ostertag/UACS/README.md

# UACS
University Access Controll System
