ostertag/UACS/stm32_interface/README.md

Here are schematics of connecting STM32F103C8T6 to our custom PCB
