ostertag/UACS/audio_amplifier/README.md

Here are schematics for UACS audio interface
