ostertag/UACS/leds/README.md

Here are schematics and short description for UACS LEDs
