ostertag/UACS/usb/README.md

Here are schematics and short description for UACS USB interface
