ostertag/UACS/reader/README.md

Here are all schematics, board designs and firmware source codes.
