ostertag/UACS/reader/hardware/README.md

Here is whole project from KICAD ver 9  
For production on JLCPCB site is advised to used plugin Fabrication toolkit for creating boom and plt files  
For detailed descriptions on of components, refer to [branch hardware_kozuch](https://github.com/ostertag/UACS/tree/hardwear_kozuch)
