ostertag/UACS/whole_reader/reader/cc-by-nc-sa-eu.png

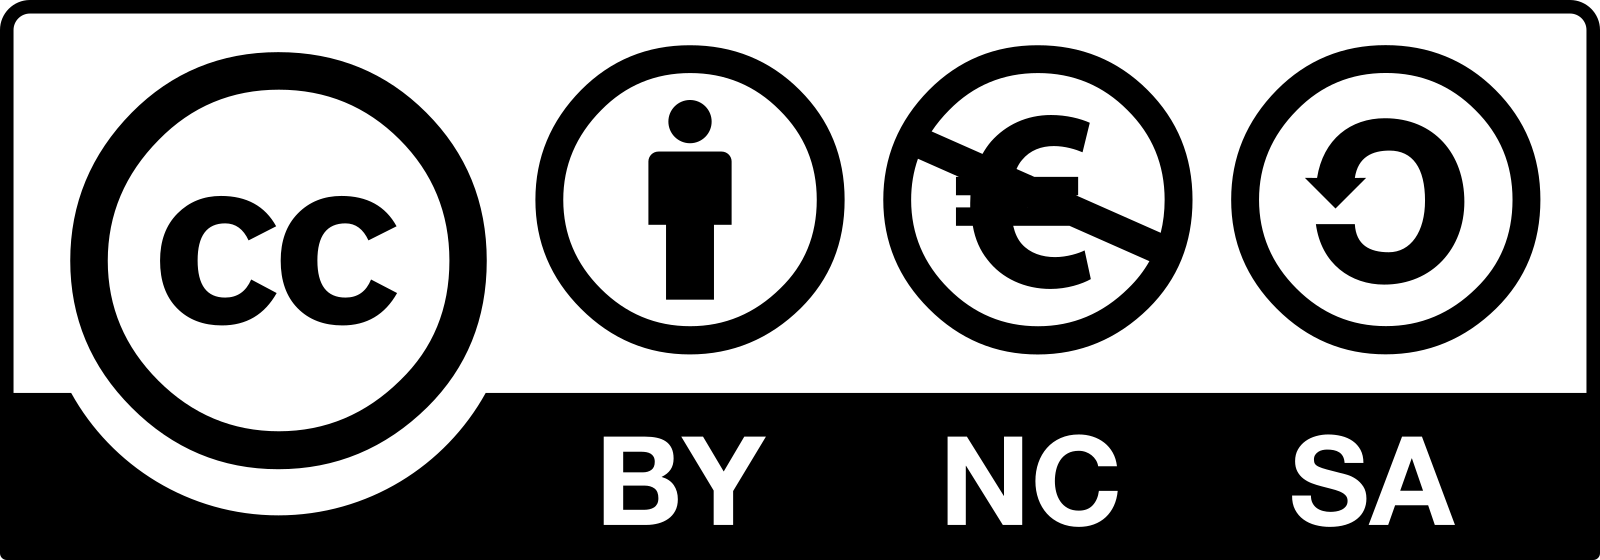
whole_reader/reader/cc-by-nc-sa-eu.png
