ostertag/UACS/whole_reader/reader/reader.png

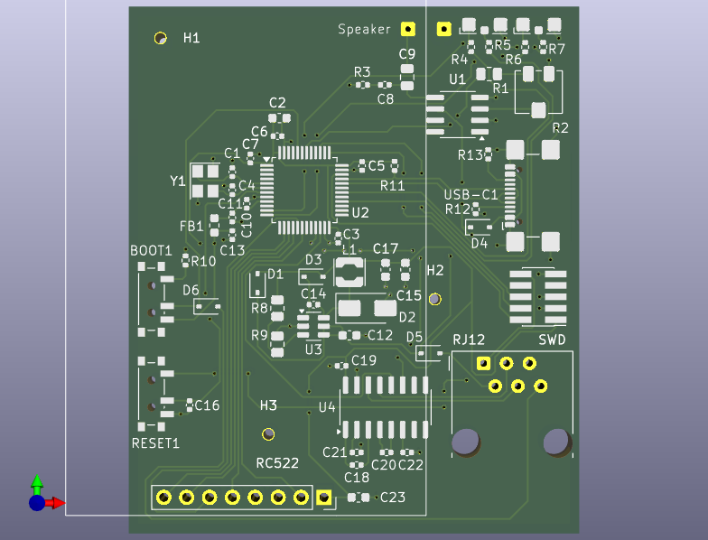
whole_reader/reader/reader.png
