ostertag/UACS/whole_reader/reader/reader_b.png

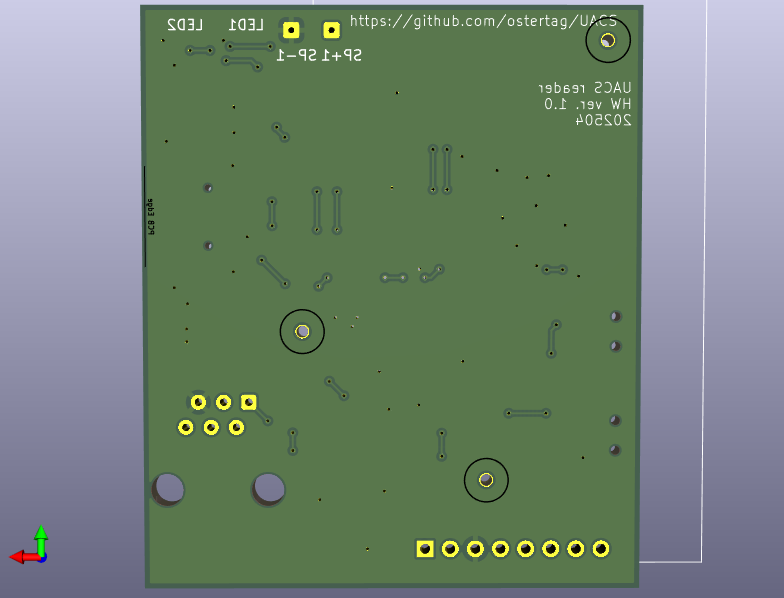
whole_reader/reader/reader_b.png
