ostertag/UACS/V2/kicad/LQFP48_STM.step

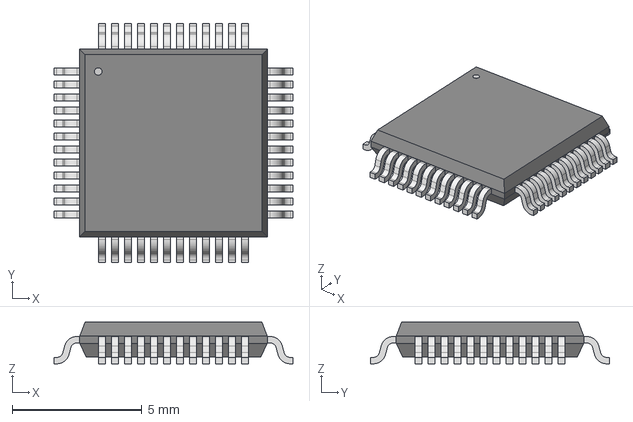
[picture p19: CAD file, 2026-04-23]
V2/kicad/LQFP48_STM.step
9.19 x 9.19 x 1.60 mm
