ostertag/UACS/whole_reader/reader/3D_models/APFA3010.STEP

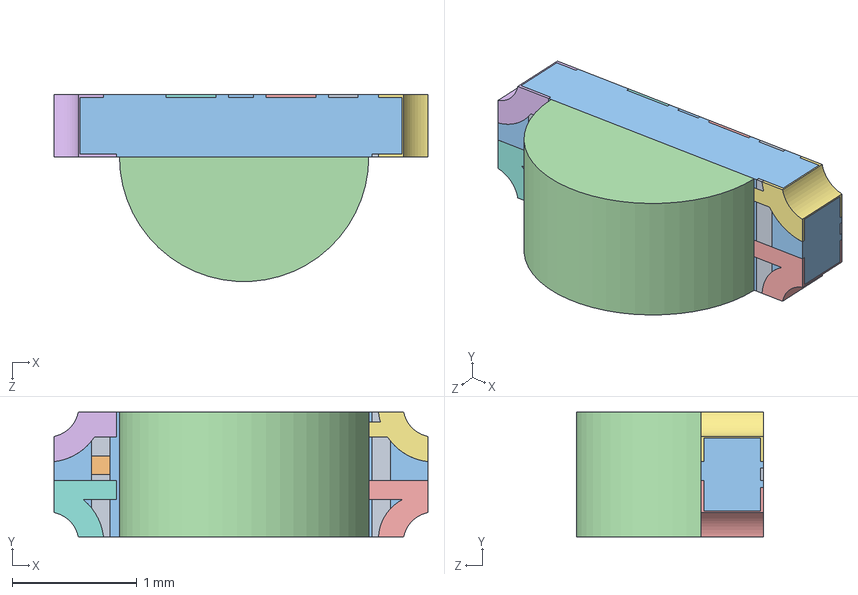
[picture p20: CAD file, 2026-03-26]
whole_reader/reader/3D_models/APFA3010.STEP
3.00 x 1.00 x 1.50 mm
