ostertag/UACS/whole_reader/reader/3D_models/GCT_USB4110GFA/USB4110-GF-A.stp

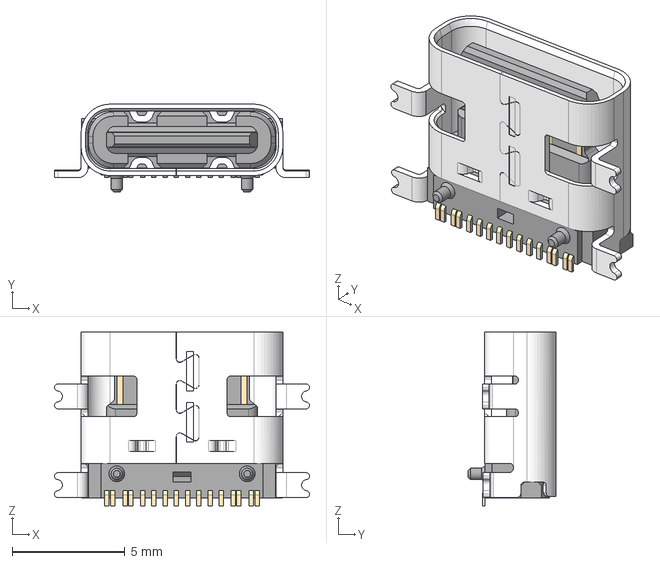
[picture p21: CAD file, 2026-03-26]
whole_reader/reader/3D_models/GCT_USB4110GFA/USB4110-GF-A.stp
11.3 x 3.89 x 7.70 mm
