ostertag/UACS/whole_reader/reader/3D_models/162191322-3-0530470210/0530470210.stp

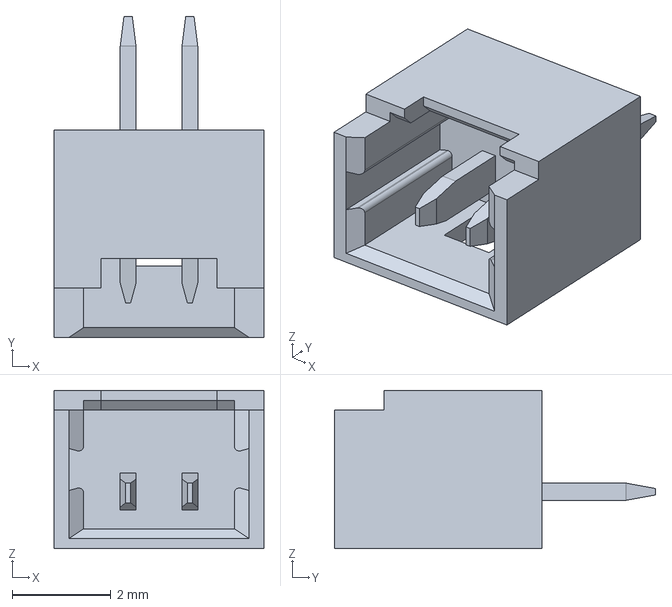
[picture p22: CAD file, 2026-03-26]
whole_reader/reader/3D_models/162191322-3-0530470210/0530470210.stp
4.25 x 6.50 x 3.20 mm
