ostertag/UACS/whole_reader/reader/3D_models/54601_906WPLF/54601-906WPLF.step

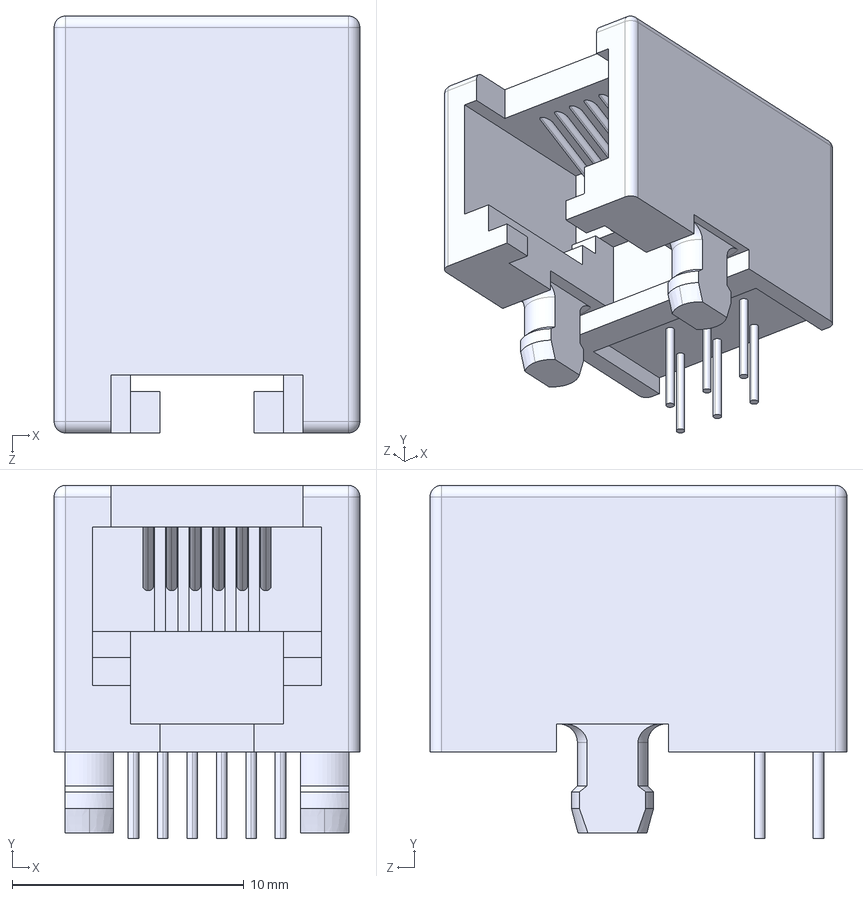
[picture p23: CAD file, 2026-03-26]
whole_reader/reader/3D_models/54601_906WPLF/54601-906WPLF.step
13.2 x 15.2 x 18.0 mm
