ostertag/UACS/(list of files, cad)

Other CAD files:
whole_reader/reader/3D_models/GCT_USB4110GFA/USB4110-GF-A.stl
