ostertag/UACS/whole_reader/reader/LTspice/Low pass PWM to audio filter.asc

C1: cap; 100n; V=4
C2: cap; 100n; V=4
C3: cap; 10n; V=4
C4: cap; 100n; V=16
C5: cap; 100µ; V=16
C6: cap; 100n; V=4
R1: res; 180; pwr=0.062
R2: res; 180; pwr=0.062
R3: res; 10; pwr=0.062
R4: res; 20k; pwr=0.062
R5: res; 6.2k; pwr=0.062
R7: res; 180; pwr=0.062
R8: res; 82k; pwr=0.062
Rs: res; 8; pwr=0.5
U1: LM386
V1: voltage; PWL file=pwm_signal.pwl; AC 1
V2: voltage; 12
V5: voltage; SINE(0.5 0.5 1k)
V6: voltage; PWL file=audio_signal.pwl
Named nets: 0, PWM, LP1, LP2, LP3, Sample, Audio, HP, Ain, Aout, Speaker
.ac dec 100 10 100k
.tran 12m
HP cutoff
194 Hz
HP cutoff
199 Hz
LP cutoff 8.8 kHz
remove DC offset
remove DC offset
.meas TRAN Pspeaker AVG V(Speaker)*I(Rs) FROM 1m TO 9m
.measure TRAN AinMax MAX V(Ain) FROM 1m to 9m
.measure TRAN AinMin MIN V(Ain) FROM 1m to 9m
< 0.5 W
< 0.4 V
> -0.4 V
.measure TRAN Imax MAX I(V1) FROM 1m to 9m
< 20 mA
.measure TRAN Imin MIN I(V1) FROM 1m TO 9m
> -20 mA
https://jlcpcb.com/partdetail/Inghai-GSPK151035PN_8R0_5W_L35_125T/C530539
