ostertag/UACS/reader/hardware/reader.kicad_pcb

## KiCad design reader/hardware/reader.kicad_pcb (2026-04-23)

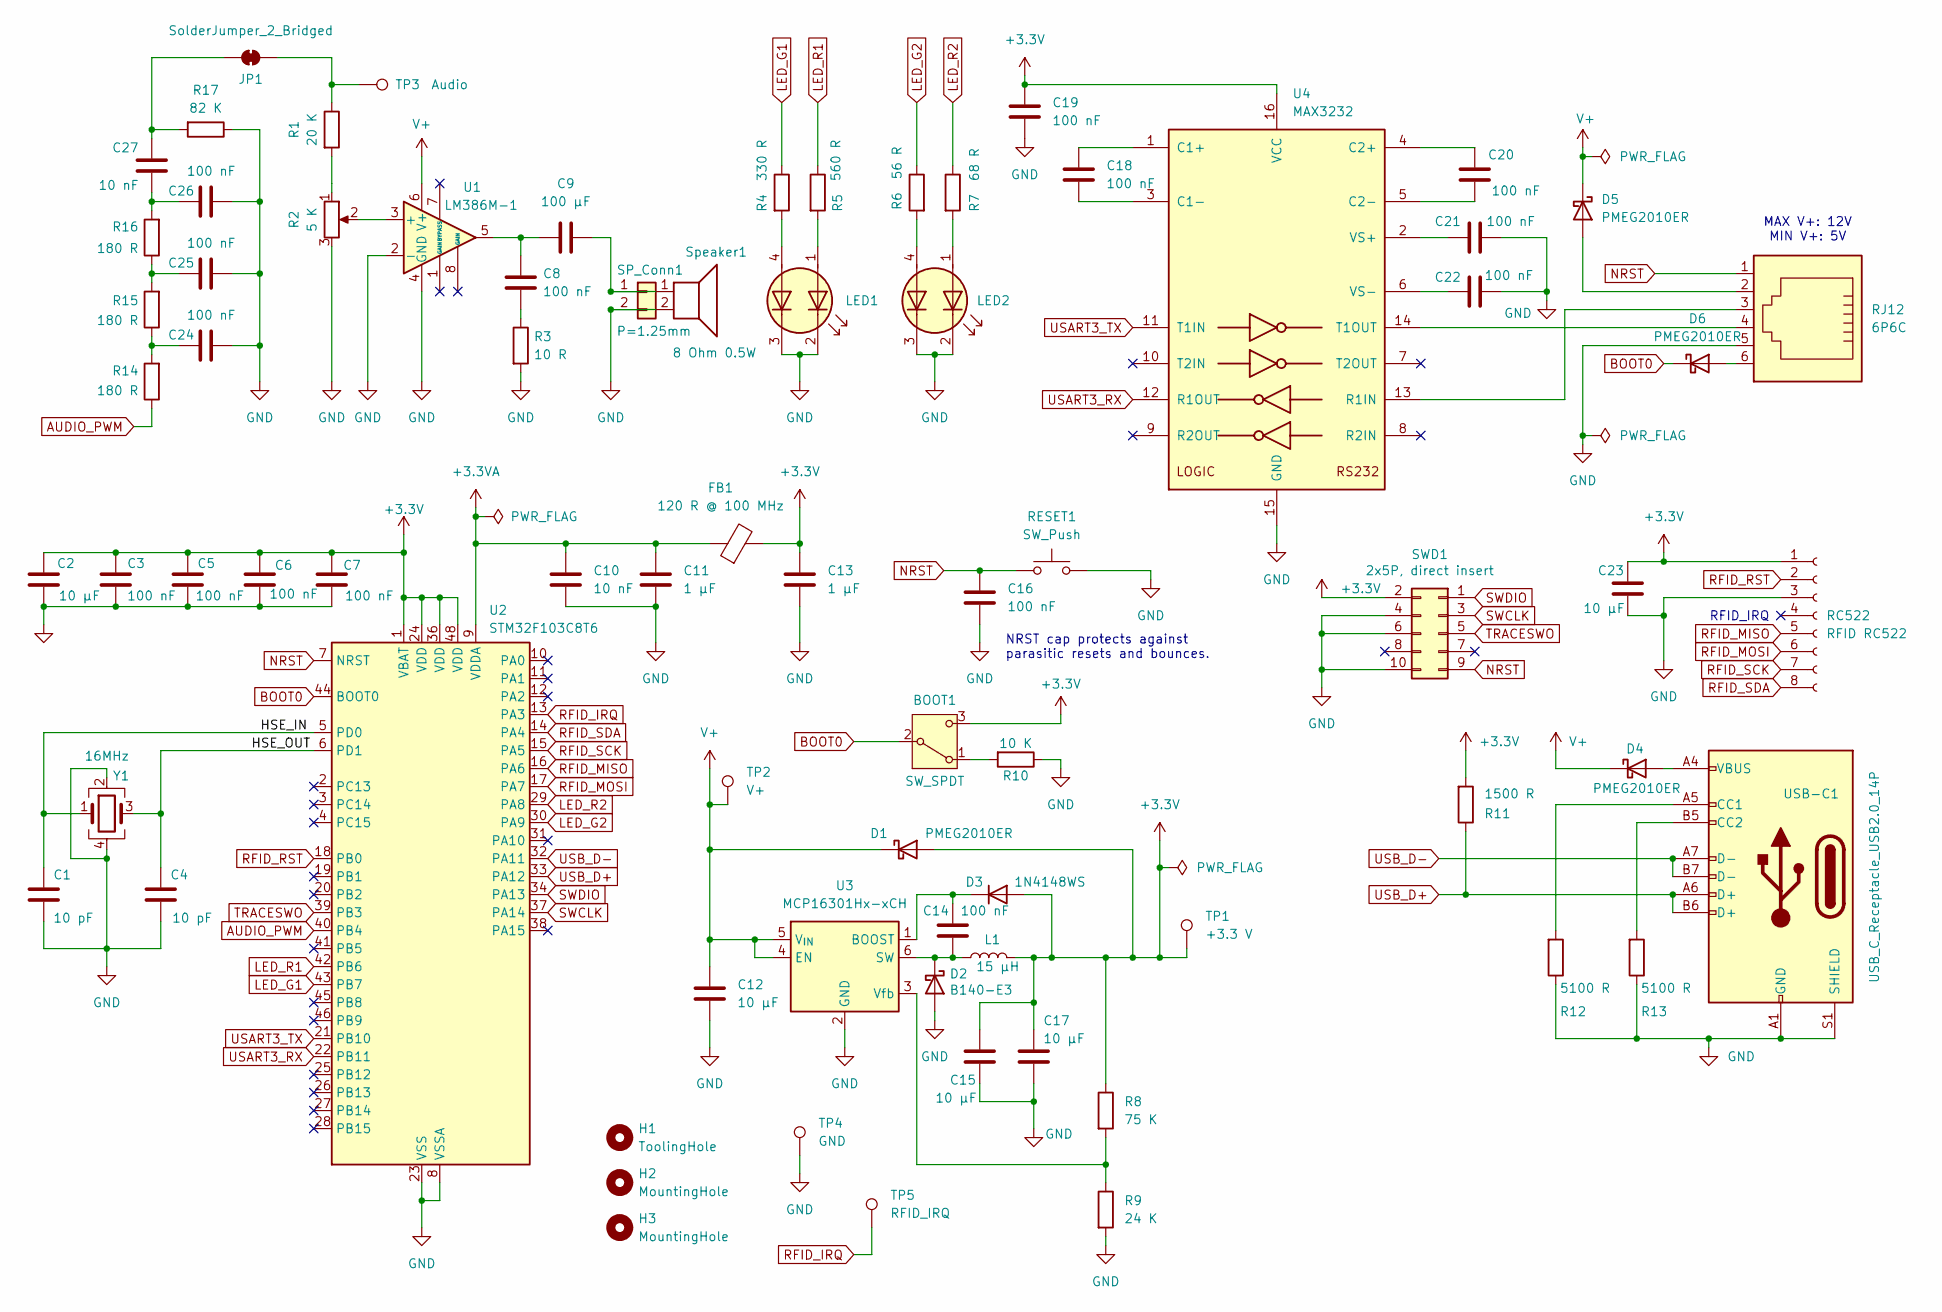
[picture p24: schematic reader.kicad_sch, ${title}]

Parts:
BOOT1: SW_SPDT; SW_SPDT_PCM12; LCSC C109335
C1, C4: 10 pF; C_0402_1005Metric; LCSC C32949
C2, C12, C15, C17, C23: 10 µF; C_0603_1608Metric; LCSC C96446
C3, C5, C6, C7, C8, C14, C16, C18, C19, C20, C21, C22, C24, C25, C26: 100 nF; C_0402_1005Metric; LCSC C1525
C9: 100 µF; C_1206_3216Metric; LCSC C15008
C10, C27: 10 nF; C_0402_1005Metric; LCSC C15195
C11, C13: 1 µF; C_0402_1005Metric; LCSC C52923
D1, D4, D5, D6: PMEG2010ER; Nexperia_CFP3_SOD-123W; LCSC C82288
D2: B140-E3; D_SMA; LCSC C968568
D3: 1N4148WS; D_SOD-323; LCSC C2128
FB1: 120 R @ 100 MHz; L_0603_1608Metric; LCSC C2661467
H1: ToolingHole; ToolingHole_1.152mm
H2, H3: MountingHole; ToolingHole_1.152mm
JP1: SolderJumper_2_Bridged; SolderJumper-2_P1.3mm_Bridged_RoundedPad1.0x1.5mm
L1: 15 µH; L_Coilcraft_LPS3010; LCSC C520285
LED1: APHBM2012LSURKZGKC; LED_Kingbright_APHBM2012_2x1.25mm; LCSC C6465979
LED2: APHBM2012SURKCGKC; LED_Kingbright_APHBM2012_2x1.25mm; LCSC C5553822
R1: 20 K; R_0402_1005Metric; LCSC C25765
R2: 5 K; Potentiometer_Bourns_3314J_Vertical; LCSC C58391
R3: 10 R; R_0402_1005Metric; LCSC C25077
R4: 330 R; R_0402_1005Metric; LCSC C25104
R5: 560 R; R_0603_1608Metric; LCSC C23204
R6: 56 R; R_0402_1005Metric; LCSC C25127
R7: 68 R; R_0402_1005Metric; LCSC C163455
R8: 75 K; R_0603_1608Metric; LCSC C23242
R9: 24 K; R_0603_1608Metric; LCSC C23352
R10: 10 K; R_0603_1608Metric; LCSC C25804
R11: 1500 R; R_0402_1005Metric; LCSC C25867
R12, R13: 5100 R; R_0402_1005Metric; LCSC C25905
R14, R15, R16: 180 R; R_0402_1005Metric; LCSC C102848
R17: 82 K; R_0603_1608Metric; LCSC C23254
RC522: RFID RC522; PinSocket_1x08_P2.54mm_Vertical; LCSC C27438
RESET1: SW_Push; SW_PUSH_6mm; LCSC C2889001
RJ12: 6P6C; RJ12_Amphenol_54601-x06_Horizontal; LCSC C4355015
SP_Conn1: P=1.25mm; Molex_PicoBlade_53047-0210_1x02_P1.25mm_Vertical; LCSC C114130
SWD1: 2x5P, direct insert; PinSocket_2x05_P1.27mm_Vertical; LCSC C350287
Speaker1: 8 Ohm 0.5W; LCSC C530539
TP1: +3.3 V; TestPoint_THTPad_D1.0mm_Drill0.5mm
TP2: V+; TestPoint_THTPad_D1.0mm_Drill0.5mm
TP3: Audio; TestPoint_THTPad_D1.0mm_Drill0.5mm
TP4: GND; TestPoint_THTPad_D1.0mm_Drill0.5mm
TP5: RFID_IRQ; TestPoint_THTPad_D1.0mm_Drill0.5mm
U1: LM386M-1; SOIC-8_3.9x4.9mm_P1.27mm; LCSC C5375298
U2: STM32F103C8T6; LQFP-48_7x7mm_P0.5mm; LCSC C8734
U3: MCP16301Hx-xCH; SOT-23-6; LCSC C511272
U4: MAX3232; SOIC-16_3.9x9.9mm_P1.27mm; LCSC C81661
USB-C1: USB_C_Receptacle_USB2.0_14P; USB_C_Receptacle_GCT_USB4105-xx-A_16P_TopMnt_Horizontal; LCSC C2765186
Y1: 16MHz; Crystal_SMD_3225-4Pin_3.2x2.5mm; LCSC C13738

Connections:
+3.3V: BOOT1.3 (C), C2.1, C3.1, C5.1, C6.1, C7.1, C13.1, C15.1, C17.1, C19.1, C23.1, D1.2 (A), D3.2 (A), FB1.2, L1.2, R8.1, R11.2, RC522.1, SWD1.2, TP1.1, U2.1 (VBAT), U2.24 (VDD), U2.36 (VDD), U2.48 (VDD), U4.16 (VCC)
+3.3VA: C10.1, C11.1, FB1.1, U2.9 (VDDA)
/HSE_IN: C1.1, U2.5 (PD0), Y1.1
/HSE_OUT: C4.1, U2.6 (PD1), Y1.3
AUDIO_PWM: R14.1, U2.40 (PB4)
BOOT0: BOOT1.2 (B), D6.1 (K), U2.44 (BOOT0)
GND: C1.2, C2.2, C3.2, C4.2, C5.2, C6.2, C7.2, C10.2, C11.2, C12.2, C13.2, C15.2, C16.2, C17.2, C19.2, C21.2, C22.2, C23.2, C24.2, C25.2, C26.2, D2.2 (A), LED1.2 (K1), LED1.3 (K2), LED2.2 (K1), LED2.3 (K2), R2.3, R3.2, R9.2, R10.1, R12.1, R13.1, R17.1, RC522.3, RESET1.2, RJ12.5, SP_Conn1.2, SWD1.4, SWD1.6, SWD1.10, Speaker1.2, TP4.1, U1.2 (-), U1.4 (GND), U2.8 (VSSA), U2.23 (VSS), U2.35 (VSS), U2.47 (VSS), U3.2 (GND), U4.15 (GND), USB-C1.A1 (GND), USB-C1.A12 (GND), USB-C1.B1 (GND), USB-C1.B12 (GND), USB-C1.S1 (SHIELD), Y1.2, Y1.4
LED_G1: R4.1, U2.43 (PB7)
LED_G2: R6.1, U2.30 (PA9)
LED_R1: R5.1, U2.42 (PB6)
LED_R2: R7.1, U2.29 (PA8)
NRST: C16.1, RESET1.1, RJ12.1, SWD1.9, U2.7 (NRST)
unnamed: BOOT1.1 (A), R10.2
unnamed: C8.1, C9.1, U1.5
unnamed: C8.2, R3.1
unnamed: C24.1, R14.2, R15.1
unnamed: C25.1, R15.2, R16.1
unnamed: C26.1, C27.1, R16.2
unnamed: C14.2, D2.1 (K), L1.1, U3.6 (SW)
unnamed: C14.1, D3.1 (K), U3.1 (BOOST)
unnamed: D4.2 (A), USB-C1.A4 (VBUS), USB-C1.A9 (VBUS), USB-C1.B4 (VBUS), USB-C1.B9 (VBUS)
unnamed: D5.2 (A), RJ12.2
unnamed: D6.2 (A), RJ12.6
unnamed: C27.2, JP1.1 (A), R17.2
unnamed: JP1.2 (B), R1.1, TP3.1
unnamed: LED1.1 (A1), R5.2
unnamed: LED1.4 (A2), R4.2
unnamed: LED2.1 (A1), R7.2
unnamed: LED2.4 (A2), R6.2
unnamed: R1.2, R2.1
unnamed: C9.2, SP_Conn1.1, Speaker1.1
unnamed: R2.2, U1.3 (+)
unnamed: R8.2, R9.1, U3.3 (Vfb)
unnamed: C18.1, U4.1 (C1+)
unnamed: C18.2, U4.3 (C1-)
unnamed: C20.1, U4.4 (C2+)
unnamed: C20.2, U4.5 (C2-)
unnamed: RJ12.3, U4.13 (R1IN)
unnamed: RJ12.4, U4.14 (T1OUT)
unnamed: C21.1, U4.2 (VS+)
unnamed: C22.1, U4.6 (VS-)
unnamed: R12.2, USB-C1.A5 (CC1)
unnamed: R13.2, USB-C1.B5 (CC2)
RFID_IRQ: TP5.1, U2.13 (PA3)
RFID_MISO: RC522.5, U2.16 (PA6)
RFID_MOSI: RC522.6, U2.17 (PA7)
RFID_RST: RC522.2, U2.18 (PB0)
RFID_SCK: RC522.7, U2.15 (PA5)
RFID_SDA: RC522.8, U2.14 (PA4)
SWCLK: SWD1.3, U2.37 (PA14)
SWDIO: SWD1.1, U2.34 (PA13)
TRACESWO: SWD1.5, U2.39 (PB3)
USART3_RX: U2.22 (PB11), U4.12 (R1OUT)
USART3_TX: U2.21 (PB10), U4.11 (T1IN)
USB_D+: R11.1, U2.33 (PA12), USB-C1.A6 (D+), USB-C1.B6 (D+)
USB_D-: U2.32 (PA11), USB-C1.A7 (D-), USB-C1.B7 (D-)
V+: C12.1, D1.1 (K), D4.1 (K), D5.1 (K), TP2.1, U1.6 (V+), U3.4 (EN), U3.5 (V_{IN})

Notes on the sheet:
MAX V+: 12V MIN V+: 5V
NRST cap protects against parasitic resets and bounces.
RFID_IRQ

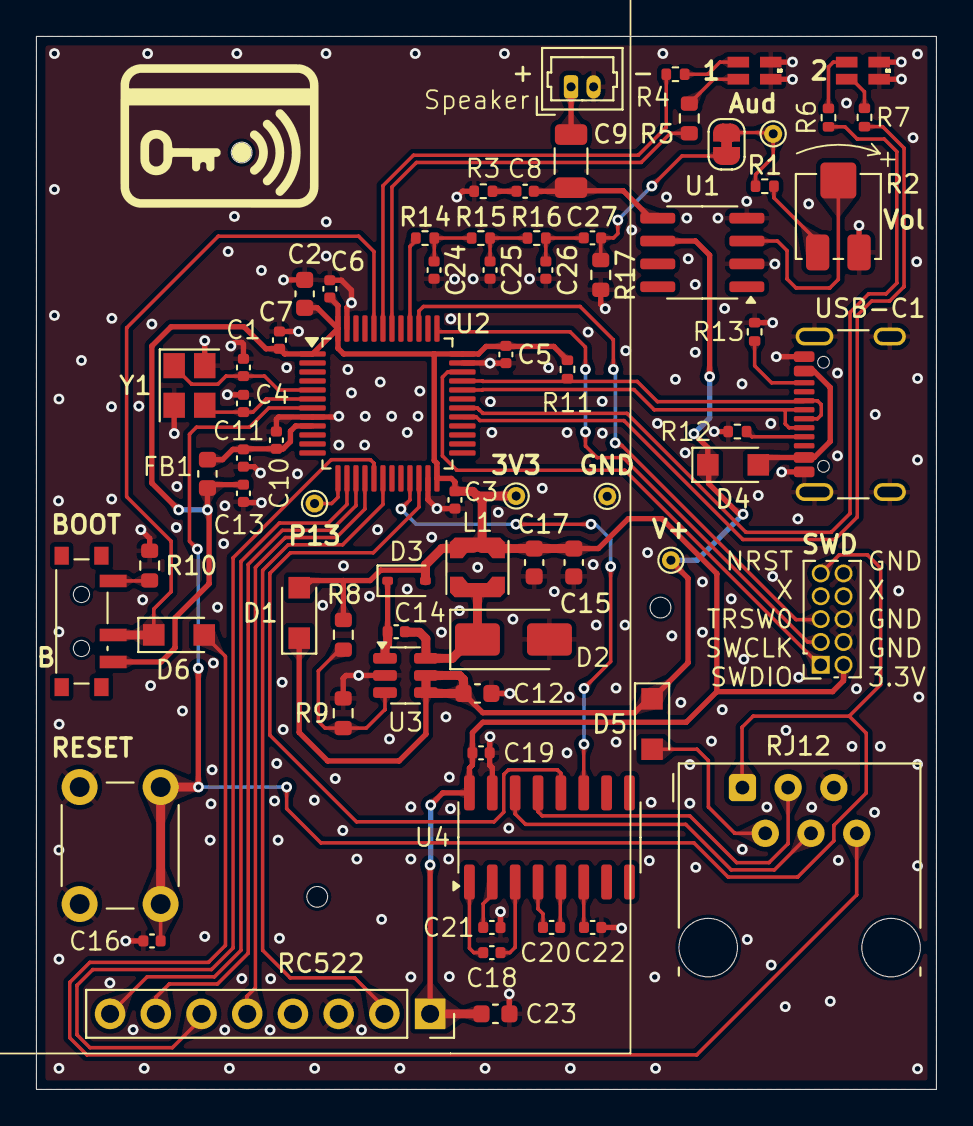
[picture p25: board reader.kicad_pcb from above]

Board: 2 copper layers, 50.0 x 58.5 mm, 75 parts (0 on the bottom side), 57 nets.
