ostertag/UACS/audio_amplifier/audio_amplifier.kicad_sch

## KiCad design audio_amplifier/audio_amplifier.kicad_sch (2026-04-23)

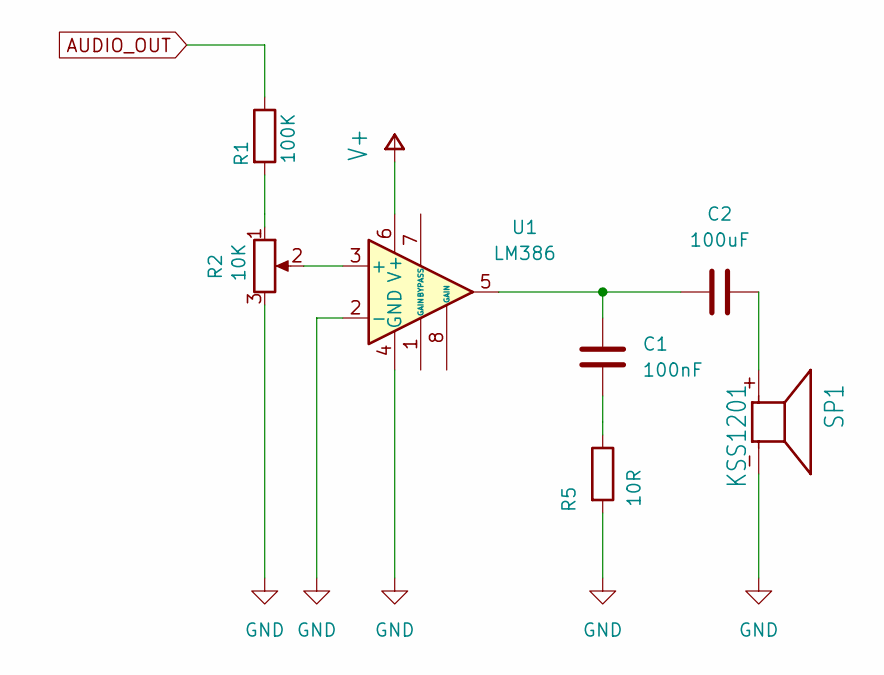
[picture p26: schematic audio_amplifier.kicad_sch]

Parts:
C1: 100nF
C2: 100uF
R1: 100K
R2: 10K
R5: 10R
SP1: KSS1201
U1: LM386

Connections:
AUDIO_OUT: R1.1
GND: R2.3, R5.2, SP1.- (2), U1.2 (-), U1.4 (GND)
unnamed: C1.1, C2.1, U1.5
unnamed: C1.2, R5.1
unnamed: C2.2, SP1.+ (1)
unnamed: R1.2, R2.1
unnamed: R2.2, U1.3 (+)
V+: U1.6 (V+)
