ostertag/UACS/leds/KAA-3528SRSGS.kicad_sch

## KiCad design leds/KAA-3528SRSGS.kicad_sch (2026-04-23)

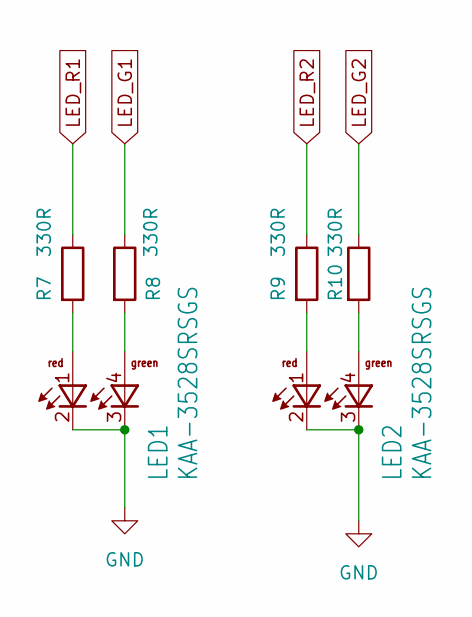
[picture p27: schematic KAA-3528SRSGS.kicad_sch]

Parts:
LED1, LED2: KAA-3528SRSGS
R7, R8, R9, R10: 330R

Connections:
GND: LED1.2 (C-RED), LED1.3 (C-GREEN), LED2.2 (C-RED), LED2.3 (C-GREEN)
LED_G1: R8.1
LED_G2: R10.1
LED_R1: R7.1
LED_R2: R9.1
unnamed: LED1.1 (A-RED), R7.2
unnamed: LED1.4 (A-GREEN), R8.2
unnamed: LED2.1 (A-RED), R9.2
unnamed: LED2.4 (A-GREEN), R10.2
