ostertag/UACS/usb/usb_c.kicad_sch

## KiCad design usb/usb_c.kicad_sch (2026-04-23)

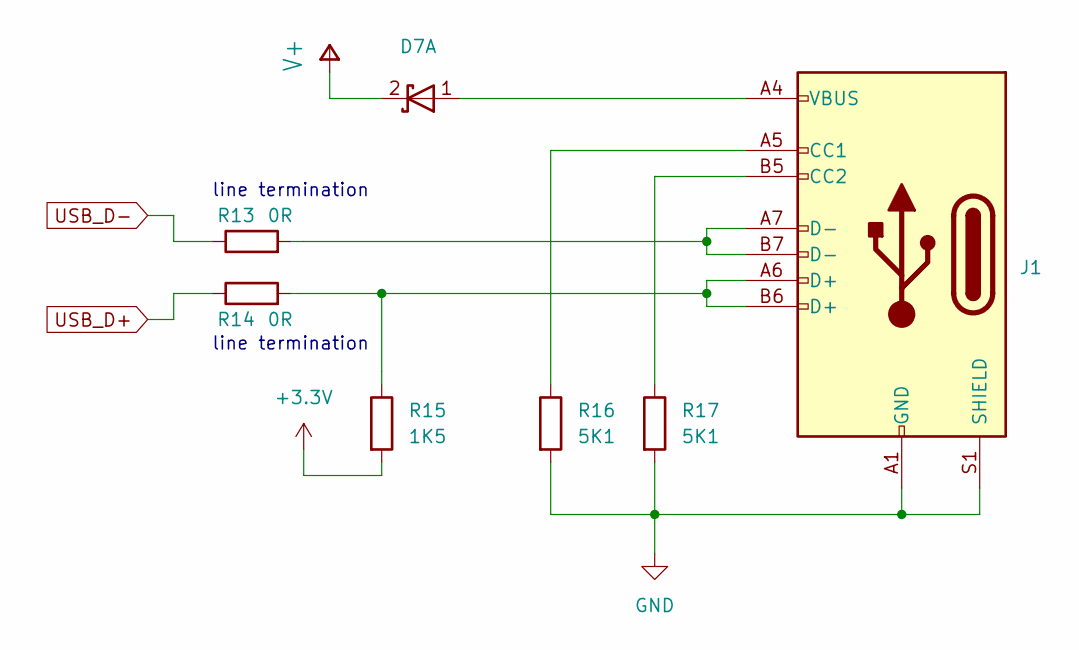
[picture p28: schematic usb_c.kicad_sch]

Parts:
D7: (no value)
J1: (no value)
R13, R14: 0R
R15: 1K5
R16, R17: 5K1

Connections:
+3.3V: R15.2
GND: J1.A1 (GND), J1.A12 (GND), J1.B1 (GND), J1.B12 (GND), J1.S1 (SHIELD), R16.2, R17.2
unnamed: D7.1 (A), J1.A4 (VBUS), J1.A9 (VBUS), J1.B4 (VBUS), J1.B9 (VBUS)
unnamed: J1.A5 (CC1), R16.1
unnamed: J1.A6 (D+), J1.B6 (D+), R14.2, R15.1
unnamed: J1.A7 (D-), J1.B7 (D-), R13.2
unnamed: J1.B5 (CC2), R17.1
USB_D+: R14.1
USB_D-: R13.1
V+: D7.2 (K)

Notes on the sheet:
line termination
