ostertag/UACS/V2/stm32_pins.ioc

Mcu.UserName=STM32H523CETx
PA1.Signal=GPIO_Output
PA10.Signal=USART1_RX
PA11.Signal=USB_DM
PA12.Signal=USB_DP
PA13(JTMS/SWDIO).Signal=DEBUG_JTMS-SWDIO
PA14(JTCK/SWCLK).Signal=DEBUG_JTCK-SWCLK
PA2.Signal=GPIO_Output
PA3.Signal=I2S3_SDO
PA4.Signal=I2S3_WS
PA5.Signal=SPI1_SCK
PA6.Signal=SPI1_MISO
PA7.Signal=SPI1_MOSI
PA9.Signal=USART1_TX
PB0.Signal=GPIO_Output
PB1.Signal=GPIO_Input
PB12.Signal=GPIO_Output
PB13.Signal=GPIO_Output
PB14.Signal=SPI2_MISO
PB15.Signal=SPI2_MOSI
PB2.Signal=SPI2_SCK
PB3(JTDO/TRACESWO).Signal=I2S3_CK
PB5.Signal=GPIO_Output
PB6.Signal=GPIO_Output
PB7.Signal=FDCAN1_TX
PB8.Signal=FDCAN1_RX
PH0-OSC_IN(PH0).Signal=RCC_OSC_IN
PH1-OSC_OUT(PH1).Signal=RCC_OSC_OUT
