ostertag/UACS/reader/firmware_for_testing/main.c

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
/* Includes ------------------------------------------------------------------*/
#include "main.h"
#include "usb_device.h"

/* USER CODE BEGIN Includes */
#include <math.h>
#include "rc522.h"

/* USER CODE END Includes */

/* USER CODE BEGIN PTD */
typedef struct {
    GPIO_TypeDef *port;
    uint16_t pin;
} LedConfig_t;
/* USER CODE END PTD */

/* USER CODE BEGIN PD */
#define SAMPLES 64
#define PI 3.14159265358979323846f
#define LED_COUNT 4
/* USER CODE END PD */

SPI_HandleTypeDef hspi1;

TIM_HandleTypeDef htim2;
TIM_HandleTypeDef htim3;

UART_HandleTypeDef huart3;
DMA_HandleTypeDef hdma_usart3_tx;
DMA_HandleTypeDef hdma_usart3_rx;

/* USER CODE BEGIN PV */
uint16_t sine_table[SAMPLES];
uint8_t sample_no = 0;

/* variables for managing receptions*/
volatile uint8_t uart_running = 0;
volatile uint8_t rc522_running = 0;

/* variables for managing leds*/
uint8_t state = 0;
uint8_t current_led = 0;
uint32_t blink_duration = 200;
uint32_t last_change_time = 0;
uint8_t total_cycles = 0;
uint8_t completed_cycles = 0;
uint8_t sequence_active = 0;
char led_status[] = "grgr";

/*variables for reading and recepting UID of cards*/
uint8_t status;
uint8_t sNum[8];
uint8_t card_id[8];
uint8_t tmp[8];
char out[24];

/*uart buffers*/
uint8_t uart_txbuf[64];
uint8_t uart_rxbuf[64];

/*usb buffer*/
char rx_buffer[1024];
uint8_t rx_index = 0;



/* USER CODE END PV */

void SystemClock_Config(void);
static void MX_GPIO_Init(void);
static void MX_DMA_Init(void);
static void MX_SPI1_Init(void);
static void MX_USART3_UART_Init(void);
static void MX_TIM3_Init(void);
static void MX_TIM2_Init(void);
/* USER CODE BEGIN 0 */
LedConfig_t led_sequence[LED_COUNT] = {
    {GPIOB, GPIO_PIN_6},
    {GPIOB, GPIO_PIN_7},
    {GPIOA, GPIO_PIN_8},
    {GPIOA, GPIO_PIN_9}
};
typedef enum {
    MENU_MAIN,
    MENU_LED,
	MENU_BLICK,
    MENU_UART,
    MENU_TIMER,
	MENU_RC522,
} MenuState;

MenuState currentMenu = MENU_MAIN;
/* USER CODE END 0 */

/**
  * @brief  The application entry point.
  * @retval int
  */
int main(void)
{

  /* MCU Configuration--------------------------------------------------------*/

  /* Reset of all peripherals, Initializes the Flash interface and the Systick. */
  HAL_Init();

  /* Configure the system clock */
  SystemClock_Config();

  /* Initialize all configured peripherals */
  MX_GPIO_Init();
  MX_DMA_Init();
  MX_SPI1_Init();
  MX_USART3_UART_Init();
  MX_USB_DEVICE_Init();
  MX_TIM3_Init();
  MX_TIM2_Init();

  /* USER CODE BEGIN 2 */

  MFRC522_Init();
  Generate_Pulse_Lenght();
  Period_Led_Blick(2);
  Print_Menu();
  /* USER CODE END 2 */

  /* Infinite loop */
  /* USER CODE BEGIN WHILE */
  while (1)
  {
    /* USER CODE END WHILE */

    /* USER CODE BEGIN 3 */
	  Led_Sequence_Update();
	  status = MFRC522_Request(PICC_REQIDL, card_id);
	  status = MFRC522_Anticoll(sNum);
	  memcpy(tmp, sNum, 5);

	  if(rc522_running && (tmp[0] != 147 && tmp[1] != 32)){
		  sprintf(out, "%x%x%x%x%x\r\n", tmp[0], tmp[1], tmp[2], tmp[3], tmp[4]);
		  CDC_Transmit_FS(out, sizeof(out));
	  }else if (uart_running){
		  HAL_UART_Transmit(&huart3, uart_txbuf, sizeof(uart_txbuf), 100);
	  }
	  HAL_UART_Receive_IT(&huart3, uart_rxbuf, sizeof(uart_rxbuf));
  }
  /* USER CODE END 3 */
}

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
/* USER CODE BEGIN 4 */
int _write(int file, char *ptr, int len) {
	CDC_Transmit_FS((uint8_t*) ptr, len);
	return len;
}

void Led_Sequence_Update(void) {
    if (!sequence_active) return;

    uint32_t now = HAL_GetTick();

    if (state == 0) {
        HAL_GPIO_WritePin(led_sequence[current_led].port, led_sequence[current_led].pin, GPIO_PIN_SET);
        last_change_time = now;
        state = 1;
    } else {
        if (now - last_change_time >= blink_duration) {
            HAL_GPIO_WritePin(led_sequence[current_led].port, led_sequence[current_led].pin, GPIO_PIN_RESET);
            last_change_time = now;
            state = 0;
            current_led++;

            if (current_led >= LED_COUNT) {
                current_led = 0;
                completed_cycles++;

                if (completed_cycles >= total_cycles) {
                    sequence_active = 0;
                }
            }
        }
    }
}

void Generate_Pulse_Lenght() {
    for (uint8_t i = 0; i < SAMPLES; i++) {
    	float value = ((sinf(2.0f*PI*((float)i/(float)SAMPLES)) + 1.0f)/2.0f)*1124.0f;
        sine_table[i] = value;
    }
}
void HAL_TIM_PeriodElapsedCallback(TIM_HandleTypeDef *htim){
	TIM3->CCR1 = sine_table[sample_no];
	sample_no++;
	if (sample_no > SAMPLES){
		sample_no = 0;
	}
}
void USB_CDC_RxHandler(uint8_t* Buf, uint32_t Len){
	if (Len == 0 && strcmp((char*)Buf, "\n")==0){
		Serial_Command_Handler((char*)Buf);
	}
	for (uint32_t i = 0; i < Len; i++) {
	        char ch = Buf[i];

	        if (ch == '\r' || ch == '\n') {
	            rx_buffer[rx_index] = '\0';
	            Serial_Command_Handler(rx_buffer);
	            rx_index = 0;
	        }
	        else {
	            if (rx_index < 1024 - 1) {
	                rx_buffer[rx_index] = ch;
	                rx_index++;
	            }
	        }
	    }
}
void Serial_Command_Handler(char * Buf){
	uint8_t invalid[] = "Invalid command\r\n";
	if(strcmp(Buf, "q")==0 || strcmp(Buf, "Q" )== 0){
		Print_Menu();
		switch(currentMenu){
		case MENU_TIMER:
			Timer_Stoper();
		case MENU_UART:
			UART_Stop_Tr();
		case MENU_RC522:
			RC522_Stop_Tr();
		}

		currentMenu = MENU_MAIN;
		return;
	}


	switch (currentMenu){
	case MENU_MAIN:
		if (strcmp(Buf, "T") == 0) {
			Led_Menu();
			currentMenu = MENU_LED;
		}else if (strcmp(Buf, "B") == 0){
			Blick_Menu();
			currentMenu = MENU_BLICK;
		}else if (strcmp(Buf, "U") == 0)  {
			UART_Menu();
			currentMenu = MENU_UART;
		}else if (strcmp(Buf, "P") == 0){
			Timer_Menu();
			currentMenu = MENU_TIMER;
		}else if (strcmp(Buf, "R") == 0){
			RC522_Menu();
			RC522_Start_Tr();
			currentMenu = MENU_RC522;
		}else if (strcmp(Buf, "") == 0){
			Print_Menu();
			currentMenu = MENU_MAIN;
		}else {
			CDC_Transmit_FS(invalid, sizeof(invalid));
		}
		break;
	case MENU_LED:
		uint8_t led[16];
		 if (strcmp(Buf, "") == 0){

			 sprintf((char *)led, "%s | ledtest> ", led_status);
			 CDC_Transmit_FS(led, sizeof(led));
			return;
		 }else if (strcmp(Buf, "1") == 0) {
			HAL_GPIO_TogglePin(GPIOB, GPIO_PIN_7);
			Swap_Char(0);
		}else if (strcmp(Buf, "2") == 0){
			HAL_GPIO_TogglePin(GPIOB, GPIO_PIN_6);
			Swap_Char(1);
		}else if (strcmp(Buf, "3") == 0)  {
			HAL_GPIO_TogglePin(GPIOA, GPIO_PIN_9);
			Swap_Char(2);
		}else if (strcmp(Buf, "4") == 0){
			HAL_GPIO_TogglePin(GPIOA, GPIO_PIN_8);
			Swap_Char(3);
		}else {
			CDC_Transmit_FS(invalid, sizeof(invalid));
		}
		sprintf((char *)led, "%s | ledtest> ", led_status);
		CDC_Transmit_FS(led, sizeof(led));
		break;
	case MENU_BLICK:
		 if (strcmp(Buf, "") == 0){
			 uint8_t blickled[] = "Number of cycles,delay (ms) | blinkled> ";
			 CDC_Transmit_FS(blickled, sizeof(blickled));
			return;
		 }
		char* t_c = strtok(Buf, ",");
		char* t_d = strtok(NULL, ",");
		if (strlen(t_d) != 0){
			blink_duration = atoi(t_d);
		}
		uint8_t cycles = atoi(t_c);
		Period_Led_Blick(cycles);
		uint8_t blickled[] = "Number of cycles,delay (ms) | blinkled> ";
		CDC_Transmit_FS(blickled, sizeof(blickled));
		break;
	case MENU_TIMER:
		if (strcmp(Buf, "") == 0){
			uint8_t pwm[] = "PWM\r\nFrequency of sinus (Hz) | pwmtest> ";
			CDC_Transmit_FS(pwm, sizeof(pwm));
			return;
		}
		Timer_Starter(atoi(Buf));
		uint8_t pwm[] = "PWM\r\nFrequency of sinus (Hz) | pwmtest> ";
		CDC_Transmit_FS(pwm, sizeof(pwm));
		break;
	case MENU_UART:
		UART_Start_Tr(Buf);
		break;
	}
}
void Swap_Char(uint8_t i){
	if(led_status[i] == 71 || led_status[i] == 82){
		char c =  led_status[i] + 32;
		led_status[i] = c;
	}else if(led_status[i] == 103 || led_status[i] == 114){
		char c =  led_status[i] - 32;
		led_status[i] = c;
	}
}



void Print_Menu(){
	uint8_t buf[] = "q return/end action\r\nMenu:\r\nT) Toggle led\r\nB) Blink led\r\nU) UART test\r\nP) PWM test\r\nR) RC522 test\r\nmenu> ";
	CDC_Transmit_FS(buf, sizeof(buf));
}
void Led_Menu(){
	uint8_t buf[76];
	sprintf((char *)buf, "Toggle led: \r\n1) 1 Green\r\n2) 1 Red\r\n3) 2 Green \r\n4) 2 Red\r\n%s | ledtest> ", led_status);
	CDC_Transmit_FS(buf, sizeof(buf));
	}
void Blick_Menu(){
	uint8_t buf[] = "Blink led \r\nNumber of cycles,delay (ms) | blinkled> ";
	CDC_Transmit_FS(buf, sizeof(buf));
}
void UART_Menu(){
	uint8_t buf[] = "UART \r\nWrite message | uarttest> ";
	CDC_Transmit_FS(buf, sizeof(buf));
}
void RC522_Menu(){
	uint8_t buf[] = "RC522 | Output:\r\n";
	CDC_Transmit_FS(buf, sizeof(buf));
}
void Timer_Menu(){
	uint8_t buf[] = "PWM\r\nFrequency of sinus (Hz) | pwmtest> ";
	CDC_Transmit_FS(buf, sizeof(buf));
}


void Period_Led_Blick(uint8_t cycles){
	    if (cycles == 0) return;
	    total_cycles = cycles;
	    completed_cycles = 0;
	    current_led = 0;
	    state = 0;
	    sequence_active = 1;
}

void UART_Start_Tr(char * Buf){
	uart_running = 1;
	memcpy(uart_txbuf, Buf, strlen(Buf));
}

void UART_Stop_Tr(){
	uart_running = 0;
}

void RC522_Start_Tr(){
	rc522_running = 1;
}

void RC522_Stop_Tr(){
	rc522_running = 0;
}
void Timer_Starter(uint16_t freq){
	Modify_Timer_ARR(freq);
	HAL_TIM_PWM_Start(&htim3, TIM_CHANNEL_1);
	HAL_TIM_Base_Start_IT(&htim2);
}

void Timer_Stoper(){
	HAL_TIM_PWM_Stop(&htim3, TIM_CHANNEL_1);
	HAL_TIM_Base_Stop_IT(&htim2);

}

void HAL_UART_RxCpltCallback(UART_HandleTypeDef *huart){
	CDC_Transmit_FS(uart_rxbuf, sizeof(uart_rxbuf));
}

void Modify_Timer_ARR(uint16_t freq){
	float time = 1.0f/(float)freq;
	float arr = ((time/(float)SAMPLES)*72000000.0f)/1.0f - 1.0f;
	TIM2->ARR = (uint32_t)arr;
}
/* USER CODE END 4 */
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
