ostertag/UACS/reader/firmware_for_testing/main.h

#define RFID_IRQ_Pin GPIO_PIN_3
#define RFID_IRQ_GPIO_Port GPIOA
#define RFID_SDA_Pin GPIO_PIN_4
#define RFID_SDA_GPIO_Port GPIOA
#define RFID_SCK_Pin GPIO_PIN_5
#define RFID_SCK_GPIO_Port GPIOA
#define RFID_MISO_Pin GPIO_PIN_6
#define RFID_MISO_GPIO_Port GPIOA
#define RFID_MOSI_Pin GPIO_PIN_7
#define RFID_MOSI_GPIO_Port GPIOA
#define RFID_RST_Pin GPIO_PIN_0
#define RFID_RST_GPIO_Port GPIOB
#define LED_R2_Pin GPIO_PIN_8
#define LED_R2_GPIO_Port GPIOA
#define LED_G2_Pin GPIO_PIN_9
#define LED_G2_GPIO_Port GPIOA
#define AUDIO_OUT_Pin GPIO_PIN_4
#define AUDIO_OUT_GPIO_Port GPIOB
#define LED_R1_Pin GPIO_PIN_6
#define LED_R1_GPIO_Port GPIOB
#define LED_G1_Pin GPIO_PIN_7
#define LED_G1_GPIO_Port GPIOB
