ostertag/UACS/(commit log)

2025-02-24 updating stm32
2025-03-01 updated stm32_interface
2025-03-22 adding schematics and board of whole_reader
    [reader.kicad_pcb, reader.kicad_sch]
2025-03-22 minor changes
    [reader.kicad_pcb]
2025-03-22 minor changes in pcb layout
    [reader.kicad_pcb, reader.kicad_sch]
2025-03-25 updates of physical_board
    [reader.kicad_pcb]
2025-04-01 updates of board
    [reader-B_Cu.gbr, reader-B_Mask.gbr, reader-B_Paste.gbr, reader-B_Silkscreen.gbr, reader-Edge_Cuts.gbr, reader-F_Cu.gbr, reader-F_Mask.gbr, reader-F_Paste.gbr]
2025-04-01 updating pcb
    [reader.kicad_pcb, reader.kicad_sch]
2025-04-01 updating schematic
    [reader.kicad_sch]
2025-04-01 updated pcb
    [reader.kicad_pcb]
2025-04-01 trying adding solder pads
    [reader.kicad_pcb, reader.kicad_sch]
2025-04-02 updating footprint
    [reader.kicad_pcb, reader.kicad_sch]
2025-04-05 new gerber files and updates to pcb
    [reader-B_Paste.gbr, reader_production-B_Cu.gbr, reader_production-B_Mask.gbr, reader_production-B_Paste.gbr, reader_production-B_Silkscreen.gbr, reader_production-Edge_Cuts.gbr, reader_production-F_Cu.gbr, reader_production-F_Mask.gbr]
2025-04-05 Úprava PCB a schémy zapojenia
    [reader.kicad_pcb, reader.kicad_sch]
2025-04-07 updates to pcb and added some 3d models
    [54601-906WPLF.step, APFA3010.STEP, USB4110-GF-A.stl, reader.kicad_pcb, reader.kicad_sch, reader_production.kicad_pcb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]
2025-04-07 minor tweaks on board
    [reader.kicad_pcb, reader.kicad_sch]
2025-04-08 Úprava PCB
    [reader.kicad_pcb]
2025-04-08 added button for reseting
    [reader.kicad_pcb, reader.kicad_sch]
2025-04-08 changed speaker symbol and footprint
    [reader.kicad_pcb, reader.kicad_sch]
2025-04-08 Upravy PCB
    [reader.kicad_pcb, reader.kicad_sch]
2025-04-08 updated holes for speaker
    [reader.kicad_pcb]
2025-04-08 updated speaker schematic
    [reader.kicad_pcb]
2025-04-09 Added toplayer ground copper pour
    [reader.kicad_pcb]
2025-04-10 RST -> NRST, BOOT -> BOOT0, popis pre SWD
    [reader.kicad_pcb, reader.kicad_sch]
2025-04-10 Oprava pre PWR_FLAG, doplnenie dátumu a revízie
    [reader.kicad_pcb, reader.kicad_sch]
2025-04-10 Drobné úpravy rozloženia schémy
    [reader.kicad_sch]
2025-04-11 changed notation of some components
    [reader.kicad_sch]
2025-04-11 viring diferential pair
    [reader.kicad_pcb]
2025-04-14 wired diferential pair on usb
    [reader.kicad_pcb]
2025-04-14 excluded rc522 card and speaker from bom file
    [reader.kicad_sch]
2025-04-14 Pridanie testovacích bodov
    [reader.kicad_pcb, reader.kicad_sch]
2025-04-15 Úprava schémy
    [reader.kicad_pcb, reader.kicad_sch]
2025-04-15 Add jumper for audio
    [reader.kicad_pcb, reader.kicad_sch]
2025-04-15 Netclass Power and GND track width set to 3.0 mm
    [reader.kicad_pcb]
2025-04-15 Rozšírenie GND výplne na niektorých miestach
    [reader.kicad_pcb]
2025-04-15 Pridanie slzičiek
    [reader.kicad_pcb]
2025-04-16 Drobná úprava schémy (zarovnanie kondenzátorov a popisov)
    [reader.kicad_sch]
2025-04-16 Úprava GND výplne, netclass a šírky niektorých spojov
    [reader.kicad_pcb]
2025-04-16 changed diodes
    [reader.kicad_pcb, reader.kicad_sch]
2025-04-16 added new diodes
    [reader.kicad_pcb, reader.kicad_sch]
2025-04-16 Úprava rozloženia dosky a pridanie TP5 pre RFID_IRQ
    [reader.kicad_pcb, reader.kicad_sch]
2025-04-16 Pridane checkbox Tested
    [reader.kicad_pcb]
2025-04-17 Pridanie loga
    [reader.kicad_pcb, reader.kicad_sch]
2025-04-17 Pridanie LCSC, JLSPCB, úprava TP
    [reader.kicad_pcb, reader.kicad_sch]
2025-04-17 Uzavretie GND okolo USB-C
    [reader.kicad_pcb]
2025-04-17 Pridaný dátový list a PN pre oscilátor
    [reader.kicad_sch]
2025-04-21 STM32 datasheet, drobné úpravy PCB
    [reader.kicad_pcb, reader.kicad_sch]
2025-04-21 Rerouting of AUDIO_OUT and LEDs, change of associated PINs on STM32
    AUDIO_OUT: 42 -> 40
    LED_G1: 28 -> 29 -> 43
    LED_R1: 30 -> 30 -> 42
    LED_G2: 11 -> 43 -> 30
    LED_R2: 12 -> 42 -> 29
    [reader.kicad_pcb, reader.kicad_sch]
2025-04-22 Drobné úpravy
    - pridanie linky na ST.com stránku k MCU
    - pridanie označenia polohy prepínača v režime Boot
    - pridanie popiskov LED na vrchnú stranu
    [reader.kicad_pcb, reader.kicad_sch]
2025-04-22 Použitie projektových premenných, nastavenie netclass farieb pre schému
    [reader.kicad_pcb, reader.kicad_sch]
2025-04-22 Pridanie 3D modelu pre LED
    [reader.kicad_pcb, reader.kicad_sch]
2025-04-22 Drobné úpravy popisov zosilňovača
    [reader.kicad_sch]
2025-04-22 Otočenie potenciometra a pridanie smeru otáčania
    [reader.kicad_pcb]
2025-04-24 Doplnenie dátových listov a TP sú mimo BOM
    [reader.kicad_pcb, reader.kicad_sch]
2025-04-24 updates on pcb, bom file and experimenting with footprints
    [reader.kicad_pcb, reader.kicad_sch]
2025-04-25 Úprava popisov
    [reader.kicad_pcb, reader.kicad_sch]
2025-04-25 Otočenie potenciometra
    [reader.kicad_pcb]
2025-04-27 Posunutie USB-C konektora na kraj PCB podľa vyznačenej čiary
    [reader.kicad_pcb]
2025-04-27 updated values and footprints of rezistors and other parts
    [reader.kicad_pcb, reader.kicad_sch]
2025-04-28 add some vias
    [reader.kicad_pcb]
2025-04-29 added speaker to the schematics
    [reader.kicad_sch]
2025-04-29 moved rj 12 connector
    [reader.kicad_pcb]
2025-04-29 changed rotations of components
    [reader.kicad_pcb, reader.kicad_sch]
2025-04-29 dorbné úpravy PCB
    [reader.kicad_pcb]
2025-04-29 úprava RJ12
    [reader.kicad_pcb]
2025-04-30 drobné úpravy schémy
    [reader.kicad_pcb, reader.kicad_sch]
2025-05-01 added new conector for sp and low pass filter
    [0530470210.stp, reader.kicad_pcb, reader.kicad_sch]
2025-05-04 pridanie LTspice modelu konverzie PWM na audio a jeho implementácia na PCB
    [reader.kicad_pcb, reader.kicad_sch]
2025-05-05 added part numbers and datasheets to components
    [reader.kicad_pcb, reader.kicad_sch]
2025-05-05 potenciometer 5k
    [reader.kicad_pcb, reader.kicad_sch]
2025-05-05 changed potentiometer footprint, datasheet etc...
    [reader.kicad_pcb, reader.kicad_sch]
2025-05-06 changed sp_conn
    [reader.kicad_pcb, reader.kicad_sch]
2025-05-06 changed 3d models
    [reader.kicad_pcb, reader.kicad_sch]
2025-05-06 drobné úpravy
    [reader-CuBottom.gbr, reader-CuTop.gbr, reader-EdgeCuts.gbr, reader-MaskBottom.gbr, reader-MaskTop.gbr, reader-NPTH.drl, reader-PTH.drl, reader-SilkBottom.gbr]
2025-05-29 added blinking diodes and pwm signal modulation
2026-03-11 kicad upgrade added undefined_netclass parameter
2026-04-23 - added audio ampliefier for i2s(removed old i2c circuit). - added sd card reader. - changed stm32 model. - RS232 transciever -> FDCAN transciever
    --- cleaned schematic a little
    [LQFP48_STM.step, reader.kicad_pcb, reader.kicad_sch]
2026-04-23 kicad 9 -> 10
    [reader.kicad_sch]
2026-04-23 added .gitatributes to force LF files. added ethernet connecotr , not yet connected
    [KAA-3528SRSGS.kicad_sch, audio_amplifier.kicad_sch, reader.kicad_pcb, reader.kicad_sch, usb_c.kicad_sch]
2026-04-23 connected ethernet cable. counting with CAT5 configuration
    [reader.kicad_sch]
2026-05-04 cleaning and pin change in progress
    [reader.kicad_sch]
2026-05-05 cleaned scheamtic. wired correct pins of mcu... their selection is in the stm32 selector
    [reader.kicad_sch]
2026-05-05 hopefully fixed the .history of kicad 10
2026-05-06 Cleaned schematic and removed RFID_IRQ pin
    [reader.kicad_sch]
2026-05-07 small schema changes
    [reader.kicad_sch]
