ostertag/UACS/(notices)

Notices in the files:
reader/firmware_for_testing/main.c:
Copyright (c) 2025 STMicroelectronics.
All rights reserved.
This software is licensed under terms that can be found in the LICENSE file
whole_reader/reader/3D_models/GCT_USB4110GFA/USB4110-GF-A.stp:
author */ ('License CC BY-ND 4.0'),
parts and their libraries:
CC BY-NC-SA 4.0
https://creativecommons.org/licenses/by-nc-sa/4.0
